jeremymlong/MidiDCO/Schematic.pdf

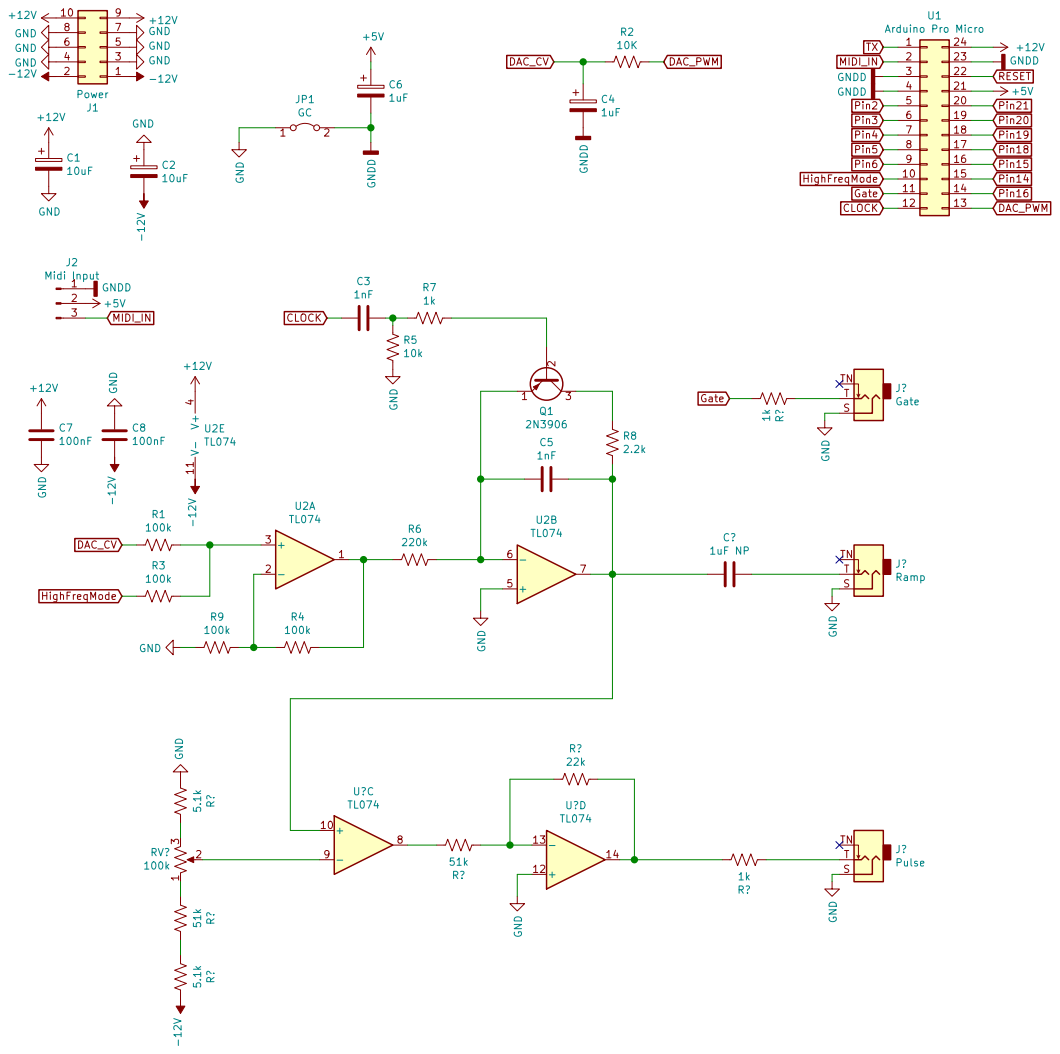
[picture p1: page 1]

Id: 1/1 Title: File: MidiDCO.sch Sheet: / 1
