jeremymlong/MidiDCO/(threads)

Thread 1 (2022-02-23):

Many errors tryiong to compile MidiDCO in Arduino IDE

Tim-Deefield, 2022-02-23:
Hi Jeremy,  I'm having many errors trying to compile the MidiDCO using Arduino1.8.19.  I started with the 1.8.15 IDE and it complained about the missing the LinkedList so I installed the latest LinkedList.  Then it complained about the #include<iostream>.  I upgraded to the 1.8.19 IDE thinking that might help but I am still having a multitude of problems too many to list but some of them are TCCR4B, PWM4B, Midi.read, TCCR4A.  Am I missing a library or using the wrong version IDE?  Some of the Google hits mentioned using LinkedList with C++ only?  I am trying to compile it for an Arduino Pro Micro as mentioned in the schematic.

Thanks for any help with this,
-Tim Heffield

Tim-Deefield, 2022-02-23:
The comment should have said #include <iostream>,  the iostream got lost somehow.
-Tim

jeremymlong, 2022-02-24:
@Tim-Deefield Yep, it wasn't building for me either.  Something must have changed in that LinkedList library. I switched it to a different library called simply [List](https://www.arduino.cc/reference/en/libraries/list/). I tested with version 2.1.0. You also need the [MIDI library](https://github.com/FortySevenEffects/arduino_midi_library). I tested this with version 5.0.2. I targeted 'Arduino Micro' and it built okay for me.  Give the updated code a try and let me know how it goes for you.

Tim-Deefield, 2022-02-24:
Hi Jeremy,

Yes that fixed it!  Thank you so much for looking into this and for the reply.  I am going out of town in the morning so I won’t be able to test the hardware till next week.  I really like the way you are using PWM to create the DCO control voltage, it’s a nice all-in-one solution…can’t wait to try it.

Regards,

-Tim

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

jeremymlong, 2022-02-24:
Glad to hear it's working for you. Let me know how the hardware portion goes.

Closed 2022-02-24.

Thread 2 (2022-03-04):

No Real issues...just comments.

Tim-Deefield, 2022-03-04:
Hi Jeremy,

I perfboarded the hardware and it all works very well.  The freq accuracy across the the octaves is amazing.  I connected a guitar tuner to it and the tuning was perfect, only C8 was slightly sharp.

I did find that the PWM DAC voltage was too high and caused clipping of the bottom of the SAW.  I changed the "magic" constant from 0.425 to 0.651 and that resolved the clipping.  I think that maybe the tolerance of the capacitor between yours and mine may explain the variation of the "magic" value.

One other thing I did was to change the PWM LPF from a 10k/1uf to a 2 pole 10k/.1uf & 1k/.01uf filter just for faster response between note changes.

Thanks again for posting this...it has been educational and fun playing with it!

-Tim

Tim-Deefield, 2022-03-04:
Hi again Jeremy,

I for got to mention...any thoughts about stacking 6 of these like a Cheetah MS6 for polyphony and spreading the MIDI notes across the 6 modules?  I guess you would need a master uP for the MIDI interface and it would assign the notes to each DCO.  You would have to deal with the individual gating too.

One other thing, I connected the clock out of the MidiDCO to an AS3397 chip to get the feel of using that chip and it works well too.  The AS3397 gives you mutltiple waveforms, 4 Pole VCF, VCA, and Left/Right panning.  The tricky part is that the Voltage Waveform (Vwf) voltage needs to be very accurate because it not only sets OSC level but also controls the shape of the waveform.  A real HW DAC is needed for this task, to do the testing I just set this voltage manually.  The Vwf voltage can be determined with a formula and you can set it to be a SAW, Triangle, Clipped Triangle or mixture of any of these with a SQR/Pulse.  Oh and the AS3397 is basically a CEM3396 with a few additions, the interface and formulas are the same.

-Tim
